MatiMasat/VibraScan/Core/Src/main.c

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
/* Includes ------------------------------------------------------------------*/
#include "main.h"

/* USER CODE BEGIN Includes */
#include "usb_device.h"
#include "app.h"
/* USER CODE END Includes */

I2C_HandleTypeDef hi2c1;

void SystemClock_Config(void);
static void MX_GPIO_Init(void);
static void MX_I2C1_Init(void);
/* USER CODE BEGIN 0 */

/* Despues de un reset con el cable conectado (por ejemplo al grabar con el
   ST-Link) la PC no se entera de que el dispositivo se desconecto y la nueva
   enumeracion falla ("Dispositivo USB desconocido"). Mantener D+ (PA12) en
   bajo unos milisegundos simula la desconexion. MX_USB_DEVICE_Init() vuelve
   a configurar el pin para el USB. */
static void usb_force_reenumeration(void)
{
  GPIO_InitTypeDef GPIO_InitStruct = {0};

  __HAL_RCC_GPIOA_CLK_ENABLE();
  HAL_GPIO_WritePin(GPIOA, GPIO_PIN_12, GPIO_PIN_RESET);
  GPIO_InitStruct.Pin = GPIO_PIN_12;
  GPIO_InitStruct.Mode = GPIO_MODE_OUTPUT_PP;
  GPIO_InitStruct.Pull = GPIO_NOPULL;
  GPIO_InitStruct.Speed = GPIO_SPEED_FREQ_LOW;
  HAL_GPIO_Init(GPIOA, &GPIO_InitStruct);
  HAL_Delay(20);
  HAL_GPIO_DeInit(GPIOA, GPIO_PIN_12);
}

/* USER CODE END 0 */

/**
  * @brief  The application entry point.
  * @retval int
  */
int main(void)
{

  /* MCU Configuration--------------------------------------------------------*/

  /* Reset of all peripherals, Initializes the Flash interface and the Systick. */
  HAL_Init();

  /* Configure the system clock */
  SystemClock_Config();

  /* USER CODE BEGIN SysInit */
  usb_force_reenumeration();
  /* USER CODE END SysInit */

  /* Initialize all configured peripherals */
  MX_GPIO_Init();
  MX_I2C1_Init();
  MX_USB_DEVICE_Init();
  /* USER CODE BEGIN 2 */
  app_init();
  /* USER CODE END 2 */

  /* Infinite loop */
  /* USER CODE BEGIN WHILE */
  while (1)
  {
    /* USER CODE END WHILE */

    /* USER CODE BEGIN 3 */
    app_loop();
  }
  /* USER CODE END 3 */
}

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
