MatiMasat/VibraScan/(commit log)

2026-10-03 Etapa 1: polling DATA_READY a 100 Hz, texto por USB CDC
2026-10-03 Etapa 2: interrupcion DATA_READY (EXTI0), I2C 400 kHz, hasta 800 Hz
2026-10-04 Etapa 2 aprobada: pruebas manuales y registro de sesion en el monitor
    - monitor_vivo.py guarda en pc/capturas/ un .log (linea por segundo,
    eventos SALTO/CORTE/GOLPE/CARA/CONTADOR y resumen al cerrar), un .csv
    con las muestras crudas y imagenes del grafico (tecla g y al cerrar).
    - Las muestras viejas que llegan al abrir el puerto no cuentan como salto.
    - README: resultados de las pruebas manuales del 2026-10-03.
    - CLAUDE.md propio del repo, con el flujo de ramas y tags por etapa.
2026-10-04 Etapa 3 paso 1: protocolo binario del lado PC y sus pruebas sin placa
    - vibrascan_proto.py: armado y decodificacion de tramas (sync A5 5A, tipo,
    largo, seq, CRC-16/CCITT-FALSE), resincronizacion ante bytes corruptos o
    perdidos, y verificador de continuidad que distingue tramas perdidas,
    muestras descartadas en el micro y huecos de INT1. Opcion --dump.
    - test_vibrascan_proto.py: 18 pruebas (unittest), sin hardware.
2026-10-04 Etapa 3 paso 2: firmware con bloques y tramas binarias con CRC
    - Bloques de 32 muestras contiguas (32 bloques, 1,3 s a 800 Hz) con n0,
    t0 en us (flanco de INT1, reloj DWT acumulado), odr, flags y cant. El
    bloque se cierra al llenarse, ante un hueco (> 1,5 periodos) o al
    cambiar el ODR.
    - trama.c: sync A5 5A, tipo, largo, seq, CRC-16/CCITT-FALSE. Muestras,
    estado y respuestas van en tramas; 2 tramas de muestras por envio USB.
    - Comandos start/stop: no se manda nada hasta start (arranque limpio);
    si el USB se desenumera deja de mandar. Nuevo contador hueco.
    - Verificado en la PC: trama.c compilado con gcc genera tramas que
    pc/vibrascan_proto.py decodifica sin errores.
    Co-Authored-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
    [app.c, trama.c, trama.h]
2026-10-04 Etapa 3 paso 3: prueba de aceptacion y monitor con el protocolo binario
    - etapa3_prueba.py: start, captura y chequeos de arranque limpio, CRC,
    tramas perdidas, descartes en el micro, huecos, tasa con t0 (sumando las
    muestras de los huecos), INT1, periodo, contadores y 1 g. CSV con el
    tiempo del reloj del micro.
    - monitor_vivo.py: lee tramas; el registro separa TRAMA PERDIDA, DESCARTE,
    HUECO y CRC. La prueba 4 se evalua por los huecos informados y la 5 pasa
    a "sin perdidas".
    - Probado contra un simulador del firmware (sin placa).
2026-10-04 Etapa 3: estado sin duplicar tras start, sps del ultimo segundo, README
    - app_loop vuelve a leer la hora antes de controlar el estado: start pone
    t_status en un tick posterior al now de la vuelta y la resta sin signo
    daba la vuelta (salia un estado de mas; lo detecto la prueba de 10 min).
    - check_stall compara con signo: t_last_read lo escribe la interrupcion.
    - int1/sps/tmin/tmax se cierran cada segundo aunque no se mande: el estado
    que sale con start ya no acumula desde el arranque.
    - README reorganizado para la etapa 3 (trama, comandos, diagnostico).
2026-10-04 Etapa 3: ventana de 1 s de int1/sps/tmin/tmax reiniciada con start y odr=
    Al separar el calculo por segundo del envio, el primer estado tras
    odr= + start cubria casi 2 s y mezclaba periodos del ODR anterior (fallaba
    "Periodo estable"). start y odr= reinician la ventana; odr= ademas informa
    0 hasta completar un segundo con el ODR nuevo.
2026-10-04 monitor_vivo: el resumen sale aunque el USB se haya desconectado
    Cerrar un puerto que ya no existe puede tirar OSError (no SerialException)
    y cortaba el programa antes del resumen. Ademas, un error dentro del
    resumen queda en el .log en vez de perderse.
    [monitor_vivo.py]
2026-10-04 CLAUDE.md: al aprobar una etapa se borra su rama (el tag tiene el mismo nombre)
2026-10-04 Etapa 4 paso 1: motor de captura a archivo y captura.py
    - vibrascan_captura.py: escribe <base>.csv (seg,n,t_s,x,y,z en cuentas)
    y <base>.json (metadatos, segmentos, eventos, perdidas, periodo por
    regresion). Segmento nuevo en cada discontinuidad (hueco, perdida,
    reconexion, ODR o rango). Reconexion automatica si se pierde el puerto.
    CSV volcado cada 1 s, JSON cada 10 s con reemplazo atomico.
    - captura.py: captura sin ventana por minutos o segundos, con nota.
    - open_stream acepta rango (se reenvia tras cada reconexion).
    - Probado con un simulador: hueco, desconexion del USB y reinicio de placa.
2026-10-04 Etapa 4 paso 2: lectura, analisis y visor de capturas
    - vibrascan_archivo.py: carga CSV+JSON (30 min en ~1,3 s), estadisticas
    por minuto, golpes (pico, duracion, vuelta al reposo, saturacion),
    saturacion por rango y envolvente min/max para graficar sin perder picos.
    - ver_captura.py: 3 ejes y |a| contra el tiempo, envolvente recalculada al
    hacer zoom, huecos/reconexiones en gris sin cruzar la linea, saturacion
    y golpes marcados, resumen por consola, --png sin ventana.
    - test_vibrascan_archivo.py: 8 pruebas, incluida una captura sintetica de
    30 min con un pico de una sola muestra.
2026-10-04 Etapa 4 paso 3: prueba de aceptacion y monitor sobre el motor de captura
    - etapa4_prueba.py: analiza capturas (no captura). reposo: completa,
    sin perdidas, un segmento, contadores, sin saturacion, deriva de la
    media por minuto <= 10 mg, ruido de cada minuto a +/-20 % de la mediana,
    1 g, base de tiempo. golpes: cantidad, duracion, vuelta al reposo y sin
    saturacion (sugiere --rango 16). Umbrales como constantes a ajustar.
    - monitor_vivo.py: usa Captura (graba en el formato de captura.py, se
    reconecta solo, --rango), dibuja con envolvente min/max en vez de 1 de
    cada k, vacia el buffer si n retrocede (placa reiniciada).
2026-10-04 Etapa 4 paso 4: comando rango= en el firmware
    rango=2|4|8|16 reconfigura el sensor sin regrabar (FULL_RES: misma escala,
    cambia el tope). El rango va en la trama de estado. Si se cambia mientras se
    transmite, la reconfiguracion deja un hueco real de unos ms y se informa
    como tal (a diferencia de odr=, el periodo no cambia). etapa=4.
2026-10-04 Etapa 4: descartar las 2 primeras muestras tras configurar el sensor
    Medido en la placa: despues de rango= u odr= (y de cualquier
    configuracion del sensor) la primera muestra sale desviada ~30 cuentas
    (0,12 g); desde la segunda todo normal. Pasaba desde la etapa 2 con odr=.
    Se descartan SETTLE_SAMPLES = 2: no suman a n (no hay salto) pero cuentan
    como ultima muestra (no hay hueco falso). Contador informativo asent.
    TEXT_MAX 200 -> 256 (el estado ocupa hasta 249 con contadores grandes) y
    buffers de send_text en memoria estatica.
2026-10-04 ver_captura: la flecha del golpe apunta al pico, no al primer cruce del umbral
2026-10-04 CLAUDE.md: borrar la rama de la etapa primero en GitHub y despues la local
2026-10-04 Etapa 5 paso 1: PSD por Welch en numpy y sus pruebas sinteticas
    - vibrascan_espectro.py: Welch propio (Hann periodica, 4096 muestras, 50 %
    de solape, media restada por tramo, densidad de una cara en g^2/Hz) para
    que la etapa 7 lo replique en el micro. Por segmento y con la tasa
    medida de cada uno (interpolado a una grilla comun); se niega a mezclar
    ODR. Picos sobre el piso local (mediana +/-20 Hz), frecuencia por
    interpolacion parabolica y amplitud rms integrando +/-3 bins menos el piso.
    - test_vibrascan_espectro.py: 15 pruebas (Parseval, ruido blanco plano,
    tonos en y entre bins, amplitud exacta sin ruido, dos tonos a 1 Hz, tasa
    nominal vs medida, segmentos, ODR mezclados, can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
2026-10-04 Etapa 5 paso 2: espectro.py con espectrograma y deteccion de aliasing
    - espectro.py: PSD de x, y, z y suma (log), picos marcados y tabla con
    frecuencia, dB sobre el piso y amplitud rms; --espectrograma, --desde,
    --hasta, --fmax, --nperseg, --png. Marca los picos que son armonicas del
    principal, directas o reflejadas por aliasing. Avisa si la senal no es
    estacionaria (Parseval < 0,95): los picos pueden ser de una resonancia
    ancha.
    - vibrascan_espectro.py: plegar(), armonica_de() y espectrograma() (256
    muestras, paso 64 o mas en capturas largas, huecos en NaN).
    - 4 pruebas nuevas (aliasing con los valores medidos, armonicas,
    espectrograma con hueco).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
2026-10-04 Etapa 5 paso 3: prueba de aceptacion con un tono de frecuencia conocida
    etapa5_prueba.py --frecuencia F: sin perdidas; el tono aparece en el
    espectrograma despues de >= 2 s de silencio (descarta un pico del
    ambiente); PSD desde el encendido; pico mas fuerte a +/-0,5 Hz de F (o de
    su alias si F > fs/2); >= 20 dB sobre el piso; Parseval +/-2 %. Lista los
    otros picos con su relacion armonica.
2026-10-08 Etapa 6 pasos 1-2: ADXL345 por SPI con FIFO y DMA, hasta 3200 Hz
    - adxl345: start_fifo (standby, bypass para vaciar, stream con watermark
    por INT1, medir), read_fifo_entries, decode_xyz publica; sale la lectura
    en bloque de 8 registros (truco de I2C).
    - sensor_spi.c: SPI1 en PA4-PA7 (CS por GPIO), modo 3 a 3 MHz (96/32; el
    sensor admite 5), DMA2 Stream0/3 canal 3, CS en alto >= 6 us entre
    transacciones (la hoja de datos pide 5 us entre lecturas del FIFO).
    - app.c: lote por aviso de INT1 (watermark 16): FIFO_STATUS y despues
    cada muestra por DMA encadenado; hora de cada muestra desde el flanco con
    el periodo nominal (en ns); FIFO lleno = ovr y hueco; si INT1 sigue en
    alto al ter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
2026-10-08 Etapa 6: diagnostico por SWD de FIFO_STATUS e INT_SOURCE
    check_devid guarda cada segundo FIFO_STATUS e INT_SOURCE en variables
    globales que se leen con el ST-Link sin detener el micro. Separan "el
    sensor no avisa" de "INT1 no llega a PB0": asi se encontro que INT1 habia
    quedado desconectado al recablear a SPI.
2026-10-08 Etapa 6 paso 3: PC para el FIFO y los ODR de 1600 y 3200 Hz
    - Contador i2c_err -> bus_err en las listas de la captura y la prueba.
    - etapa3_prueba: con fifo=N en el estado, INT1 espera entre odr/(N+3) y
    odr/N +5 % avisos por segundo (cada lote puede traer muestras de mas) y
    el periodo estable se compara contra N periodos.
    - captura.py y monitor_vivo aceptan --odr 1600 y 3200.
2026-10-09 Etapa 6: comando spi= para variar el reloj del SPI en marcha
    spi=3000|1500|750|375 (kHz, 96 MHz / 32 a 256) reconfigura el SPI y el
    sensor como rango=. El estado informa spi=<kHz>. Sirve para estudiar el
    acople de la lectura en la medicion: con el FIFO, la muestra que el sensor
    convierte durante la lectura de un lote sale desviada en Z (-20 mg a
    800 Hz, hasta -116 mg a 1600 Hz).
2026-10-09 Etapa 6: comando fifo= para variar el aviso del FIFO en marcha
    fifo=1..31 cambia el watermark (muestras por aviso de INT1) y reconfigura
    el sensor. Sirve para probar si leer cada muestra apenas esta lista (aviso
    en 1, como en las etapas 2 a 5) evita que la lectura altere la conversion
    en curso, que con lotes de 16 desvia una o dos muestras por ciclo en Z.
2026-10-09 Etapa 6: aviso del FIFO cada 2 muestras por defecto
    Medido a 3200 Hz con fifo=: con 16 u 8 por aviso, la lectura del lote se
    superpone con la conversion siguiente y desvia una o dos muestras por
    ciclo en Z (hasta -139 mg; z rms 39-43 mg con un peine de tonos). Con 4, 2
    o 1 los datos salen limpios (z rms 13 mg, todo piso blanco, sin picos). Los
    capacitores de desacople y bajar el reloj del SPI no lo resolvian. Se elige
    2: ~235 us de margen ante demoras y la mitad de interrupciones que 1.
2026-10-09 README y CLAUDE.md: etapa 6 (SPI, FIFO, acople de la lectura, conexiones)
2026-10-09 Espectrograma con tramo de ~0,32 s a cualquier ODR; bandas de etapa5_prueba en bins
    El espectrograma usaba 256 muestras fijas: 3,1 Hz de resolucion a 800 Hz
    pero 12,4 Hz a 3200 Hz, y la banda de +/-3 Hz de etapa5_prueba quedaba sin
    bins (fallaba con un arreglo vacio). Ahora el tramo es la potencia de 2 mas
    cercana a 0,32 s (1024 muestras a 3200 Hz, ~3,1 Hz) con paso de un cuarto,
    y las bandas de la prueba tienen al menos un bin.
    [espectro.py, etapa5_prueba.py, vibrascan_espectro.py]
2026-10-09 Hora correcta al reconectar INT1 y verificador de PC que no se deja arrastrar
    Al reconectar INT1 con el FIFO lleno, el flanco no es un aviso recien
    cumplido y el firmware le asignaba su hora a la muestra fifo-1: un lote
    quedo 9 ms corrido. En la PC ese bloque dio un periodo de ~28 us y el
    verificador lo promedio: el periodo quedo en 286 us (real 314,7) y cada
    bloque siguiente parecio un hueco de 0,9 ms (1917 huecos falsos en 19 s).
    - Firmware: si el lote trae mas de fifo + 3 muestras, la hora es la de la
    ultima (la que acaba de llegar).
    - vibrascan_proto.Checker: el periodo solo se promedia con mediciones a
    +/-2 % del actual; si t0 avanza menos de lo posible, evento "tiempo"
    (error de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
    [app.c, monitor_vivo.py, test_vibrascan_proto.py, vibrascan_captura.py, vibrascan_proto.py]
2026-10-09 Etapa 6: hora por continuidad en lotes sin flanco; estado periodico no gasta seq si el USB esta ocupado
    - La hora "ahora" en lotes sin flanco podia errar hasta un periodo y, tras
    reconectar INT1, simulaba un hueco de 0,6 ms y un bloque que retrocedia.
    Ahora: FIFO lleno o sin muestra anterior -> la ultima es de ahora; flanco
    de un aviso recien cumplido -> la muestra fifo-1 es la del flanco; en
    cualquier otro lote, continuidad (la anterior + un periodo): el FIFO no
    pierde muestras salvo que se llene.
    - Si el USB esta ocupado, el estado de cada segundo se saltea sin gastar
    seq (antes se descartaba y la PC lo veia como trama perdida). El estado
    que sale con start sigue esperando.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
2026-10-09 Etapa 6: resincronizar tras un FIFO lleno (solo se guardan muestras con hora confiable)
    Con el FIFO lleno, mientras se lee el sensor sigue pisando las muestras
    mas viejas: la secuencia leida ya no es continua y la hora de la ultima
    queda incierta en ~1 ms. Al reconectar INT1 eso dejaba un hueco falso de
    0,8 ms y un bloque que retrocedia. Ahora, tras un FIFO lleno, los lotes se
    leen y descartan hasta un aviso con hora exacta (< 1 ms con aviso cada 2);
    el hueco se marca una vez, con OVR, y con hora exacta a los dos lados.
2026-10-09 Etapa 6: descartar flancos de INT1 que llegaron durante un lote
    Un flanco que sube mientras se lee un lote queda pendiente en la EXTI y se
    atendia al terminar como un aviso recien cumplido, con la hora corrida (tras
    reconectar INT1 dejaba un bloque 0,75 ms fuera de lugar). release_bus borra
    el pendiente antes de mirar INT1 (si sigue en alto, otro lote por
    continuidad), y un aviso solo es exacto si el FIFO tiene al menos fifo_wm
    muestras.
